AlexanderSobolev1990/sail_catamaran_taymen/doc/SpecificationSail.odt

Поз. обозна- чение | Наименование | Кол. | Примечание
1 | Деталь грота верхняя (1) | 1
2 | Деталь грота (2) | 1
3 | Деталь грота (3) | 1
4 | Деталь грота нижняя (4) | 1
5 | Мачтовый карман | 1
6 | Лик-карман | 1
7 | Гик-карман | 1
8 | Внешний боут фаловый | 1
9 | Внутренний боут фаловый | 1
10 | Внешний боут галсовый | 1
11 | Внутренний боут галсовый | 1
12 | Внешний боут шкотовый | 1
13 | Внутренний боут шкотовый | 1
14 | Верхний латкарман (меньший) | 1
15 | Нижний латкарман (больший) | 2

Грот Спецификация Лит. Лист 0 1 Листов 1 Разраб. Пров. Н. контр. Утв. Соболев Красавин Лунёв Изм. Лист № докум. Подп. Дата Инв. № подл. Подп. и дата Взам. инв. № Инв. № дубл. Подп. и дата Копировал Формат А4

Грот Спецификация Лит. Лист 0 Листов 1 Разраб. Пров. Н. контр. Утв. Соболев Красавин Лунёв Изм. Лист № докум. Подп. Дата Инв. № подл. Подп. и дата Взам. инв. № Инв. № дубл. Подп. и дата Справ. № Перв. примен. Копировал Формат А4

Грот Спецификация Лит. Лист 0 Листов 1 Разраб. Пров. Н. контр. Утв. Соболев Красавин Лунёв Изм. Лист № докум. Подп. Дата Инв. № подл. Подп. и дата Взам. инв. № Инв. № дубл. Подп. и дата Копировал Формат А4

Лист 0 Изм. Лист № докум. Подп. Дата Инв. № подл. Подп. и дата Взам. инв. № Инв. № дубл. Подп. и дата Копировал Формат А4
