AlexanderSobolev1990/sail_catamaran_taymen/doc/Specification.odt

Поз. обозна- чение | Наименование | Кол. | Примечание
1 | Байдарка «Таймень-3» | 2
3 | Ёмкость непотопляемости | 40 | 5л ПЭТ бутыль
4 | Кильсон в сборе | 2
5 | Фальшборт | 4
6 | Шпангоут | 10
7 | Штевень | 4
| Рама катамарана
11 | Бимс, труба дюраль d40x2000x1,6мм | 4
12 | Палуба, фанера 2000х460х6мм | 2
13 | Стрингер рамы, труба дюраль d40x2000x2мм | 3 | 2 колена с соединителями
14 | Шверт | 1
| Мачта и паруса
18 | Гик, труба дюраль d30x2000x2мм | 1
19 | Грот | 1
20 | Мачта, труба дюраль d40x2000x1,6мм | 2
21 | Пластина топа мачты, сталь s4мм | 1
22 | Соединитель мачты, труба сталь d36x200x2мм | 1
23 | Стаксель | 1
24 | Флюгарка тканевая красная | 1
25 | Шток флюгарки, нерж. сталь d4мм | 1
| Рулевое устройство
31 | Балер, труба дюраль d30x600x2мм | 1
32 | Перо руля, дюраль 2мм | 1
33 | Подшипник внутр. d6мм | 2
34 | Румпель, труба дюраль d30x400x2мм | 1
35 | Румпеля привод, труба дюраль d20x2000х1,5мм | 1
36 | Стакан балера внешний, труба дюраль d40x120x1,6мм | 1
37 | Стопор стакана балера, металлич. | 1
| Такелаж
41 | Блок двойной оттяжки гика | 1
42 | Блок одинарный оттяжки гика | 1
43 | Блок одинарный фала паруса с рымом, d40мм | 2
44 | Ванта мачты боковая, стальной трос d3мм | 2
45 | Ванта мачты носовая, стальной трос d3мм | 1
46 | Зажим стального троса 3мм на двух болтах | 19
47 | Карабин легкий без завинчивающегося стопора | 2
48 | Карабин с завинчивающимся стопором | 5
49 | Коуш | 18
50 | Сорлинь | 1
51 | Снасть подъёма шверта | 1
52 | Талреп крюк-кольцо 6мм | 9
53 | Трос носовой оттяжки стрингера, сталь d3мм | 1
54 | Трос кормовой оттяжки стрингера, сталь d3мм | 1
55 | Трос Х-образной растяжки рамы, сталь d3мм | 1
56 | Трос треугольной оттяжки боковой ванты | 2
57 | Фал грота, канат 6мм | 1
58 | Фал стакселя, канат 6мм | 1
59 | Шкот стакселя, канат 6мм | 1
60 | Шкот грота, канат 6мм | 1
| Хомуты
64 | Хомут, жесть s1мм | 1 | Для стакана балера
65 | Хомут для крепления вант мачты 40мм | 4 | Для двух вант
66 | Хомут поперечного соединения труб 40мм | 4 | Из двух элементов
67 | Хомут силовой для крепления к трубе 30мм | 2 | Для оттяжки гика
68 | Хомут силовой для крепления к трубе 40мм | 2 | Для оттяжки гика
69 | Хомут Т-образного соединения труб 30мм | 1 | Для балера
70 | Хомут Т-образного соединения труб 40мм | 2 | Для степса и балера
71 | Хомут Т-образного соединения труб 50мм | 1 | Для пятки гика
| Вставки усиления
75 | Вставка усиления балера и степса, труба дюраль d36x120x2мм | 2
76 | Вставка усиления бимса, труба дюраль d36x50x2мм | 8
77 | Вставка усиления конца стрингера, труба дюраль d36x150x2мм | 2 | В нос и корму
78 | Вставка усиления пятки гика, труба дюраль d58x120x2,5мм | 1
79 | Вставка усиления хомута пятки гика, дерево | 2
80 | Вставка усиления шпангоута, дерево | 8 | Между фанерой усиления
81 | Вставка усиления шпангоута, фанера 6мм | 16
82 | Вставка усиления топа мачты, труба дюраль d36x150x2мм | 1 | С прямоуг. отв. под (21)
| Метизы
95 | Болт М4 | 2 | Или винт М4
96 | Болт М6x60 | 3
97 | Винт М6x40 кадмиевый | 26
98 | Гайка М4 | 2
99 | Гайка М6 | 45
100 | Заклепка вытяжная d4мм | 4
101 | Рым-болт М6х60 | 17
102 | Рым-гайка М6 | 2
103 | Шайба М6 | 74

Парусный катамаран Спецификация Лит. Лист 1 Листов 4 Разраб. Пров. Н. контр. Утв. Соболев Красавин Лунёв Изм. Лист № докум. Подп. Дата Инв. № подл. Подп. и дата Взам. инв. № Инв. № дубл. Подп. и дата Копировал Формат А4

Парусный катамаран Спецификация Лит. Лист 0 Листов 4 Разраб. Пров. Н. контр. Утв. Соболев Красавин Лунёв Изм. Лист № докум. Подп. Дата Инв. № подл. Подп. и дата Взам. инв. № Инв. № дубл. Подп. и дата Справ. № Перв. примен. Копировал Формат А4

Парусный катамаран Спецификация Лит. Лист 0 Листов 4 Разраб. Пров. Н. контр. Утв. Соболев Красавин Лунёв Изм. Лист № докум. Подп. Дата Инв. № подл. Подп. и дата Взам. инв. № Инв. № дубл. Подп. и дата Копировал Формат А4

Лист 4 Изм. Лист № докум. Подп. Дата Инв. № подл. Подп. и дата Взам. инв. № Инв. № дубл. Подп. и дата Копировал Формат А4
