AlexanderSobolev1990/sail_catamaran_taymen/etc/A2toA4.png

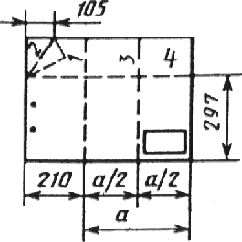
etc/A2toA4.png
