AlexanderSobolev1990/sail_catamaran_taymen/etc/Theoretical drawing of kayak Taymen-3.jpg

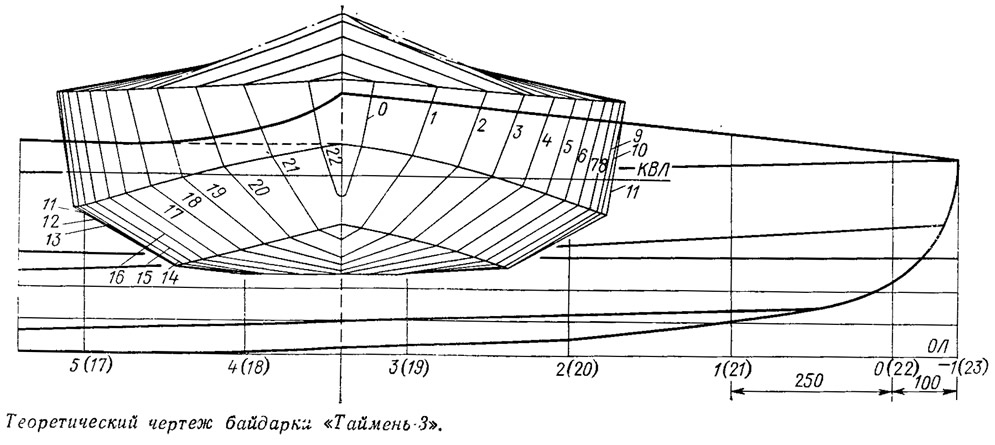
etc/Theoretical drawing of kayak Taymen-3.jpg
