AlexanderSobolev1990/sail_catamaran_taymen/doc/BOM.odt

№ п/п | Наименование (название,тип,номинал, тип корпуса и т.д.) | Обозначение документа на поставку (ГОСТ,ТУ, прайс-лист,каталог и т.п.) | Поставщик, адрес,телефон | Кол. | Ед. изм. | Примечание (цена поз., руб)
| Трубы Д16Т
1 | Труба d40x3000x2мм, | - | mpstar.ru | 2 | шт. | 16215
| с резкой пополам
2 | Труба d36x3000x2мм | - | mpstar.ru | 1 | шт. | 8050
| (резка 2м+1м)
3 | Труба d30x3000x3мм | - | mpstar.ru | 1 | шт. | 8855
| (резка 2м+1м)
4 | Труба d20x3000х2мм | - | mpstar.ru | 1 | шт. | 4620
| (рез 2,5м+0,5м)
| | | | | НДС: | 7548
| | | mpstar.ru | | | Итого:
| | | | | | 45288
| Хомуты
5 | Хомут для крепления | - | bgparus.ru | 4 | шт. | 2760
| вант мачты 40мм
6 | Хомут поперечного | - | bgparus.ru | 4 | шт. | 3120
| соединения труб 40x40мм
| (из двух элементов на гайках)
7 | Хомут силовой для | - | bgparus.ru | 2 | шт.
| крепления к трубе 30мм
8 | Хомут силовой для | - | bgparus.ru | 2 | шт. | 860
| крепления к трубе 40мм
9 | Хомут Т-образного | - | bgparus.ru | 1 | шт. | 325
| соединения труб 30х30мм
10 | Хомут Т-образного | - | bgparus.ru | 2 | шт. | 650
| соединения труб 40х40мм
11 | Хомут Т-образного | - | bgparus.ru | 1 | шт. | 325
| соединения труб 50х50мм
12 | Утка | - | bgparus.ru | 2 | шт. | 460
| Крепеж
13 | Защелка для соединения | - | bgparus.ru | 10 | шт. | 360
| труб (с 2-мя кнопками)
| | | bgparus.ru | | | Итого:
| | | | | | 8860
| Такелаж
14 | Гайка М6 самоконтр. | - | ozon.ru | 100 | шт. | 319
15 | Блок двойной | - | ozon.ru | 1 | шт. | 459
16 | Блок одинарный | - | ozon.ru | 1 | шт. | 526
17 | Блок с рымом | - | ozon.ru | 3 | шт. | 1449
18 | Болт М6x60 | - | ozon.ru | 30 | шт. | 266
19 | Зажим для троса 3мм | - | ozon.ru | 50 | шт. | 687
20 | Коуш | - | ozon.ru | 100 | шт. | 768
21 | Канат крученый 6мм | - | ozon.ru | 45 | м | 995
22 | Набор надфилей | - | ozon.ru | 1 | шт. | 454
23 | Подшипник внутр. d6мм | - | ozon.ru | 4 | шт. | 300
24 | Прут стальной на шток флюгарки | - | ozon.ru | 1 | шт. | 275
25 | Рым-гайка М6 | - | ozon.ru | 10 | шт. | 851
26 | Рым-болт М6х10 | - | ozon.ru | 4 | шт. | 418
27 | Рым-болт М6х60 | - | ozon.ru | 20 | шт. | 3992
28 | Талреп М6 | - | ozon.ru | 10 | шт. | 2597
29 | Трос стальной 50м x 3мм | - | ozon.ru | 1 | шт. | 1700
30 | Фиксатор резьбы | - | ozon.ru | 1 | шт. | 677
31 | Шайба М6 | - | ozon.ru | 100 | шт. | 182
| | | ozon.ru | | | Итого:
| | | | | | 16915
| Паруса
32 | Ткань Оксфорд (Oxford) | - | ozon.ru | 1 | шт | 1025
| 600D/1000PU 220г/м²
| 150см x 5м

Парусный катамаран Ведомость покупных изделий Лит. Лист 1 Листов 4 Разраб. Пров. Н. контр. Утв. Соболев Красавин Лунёв Изм. Лист № докум. Подп. Дата Инв. № подл. Подп. и дата Взам. инв. № Инв. № дубл. Подп. и дата Копировал Формат А4

Парусный катамаран Ведомость покупных изделий Лит. Лист 0 Листов 4 Разраб. Пров. Н. контр. Утв. Соболев Красавин Лунёв Изм. Лист № докум. Подп. Дата Инв. № подл. Подп. и дата Взам. инв. № Инв. № дубл. Подп. и дата Справ. № Перв. примен. Копировал Формат А4

Парусный катамаран Ведомость покупных изделий Лит. Лист 0 Листов 4 Разраб. Пров. Н. контр. Утв. Соболев Красавин Лунёв Изм. Лист № докум. Подп. Дата Инв. № подл. Подп. и дата Взам. инв. № Инв. № дубл. Подп. и дата Копировал Формат А4

Лист 4 Изм. Лист № докум. Подп. Дата Инв. № подл. Подп. и дата Взам. инв. № Инв. № дубл. Подп. и дата Копировал Формат А4
