AlexanderSobolev1990/sail_catamaran_taymen/jpg/parts.JPG

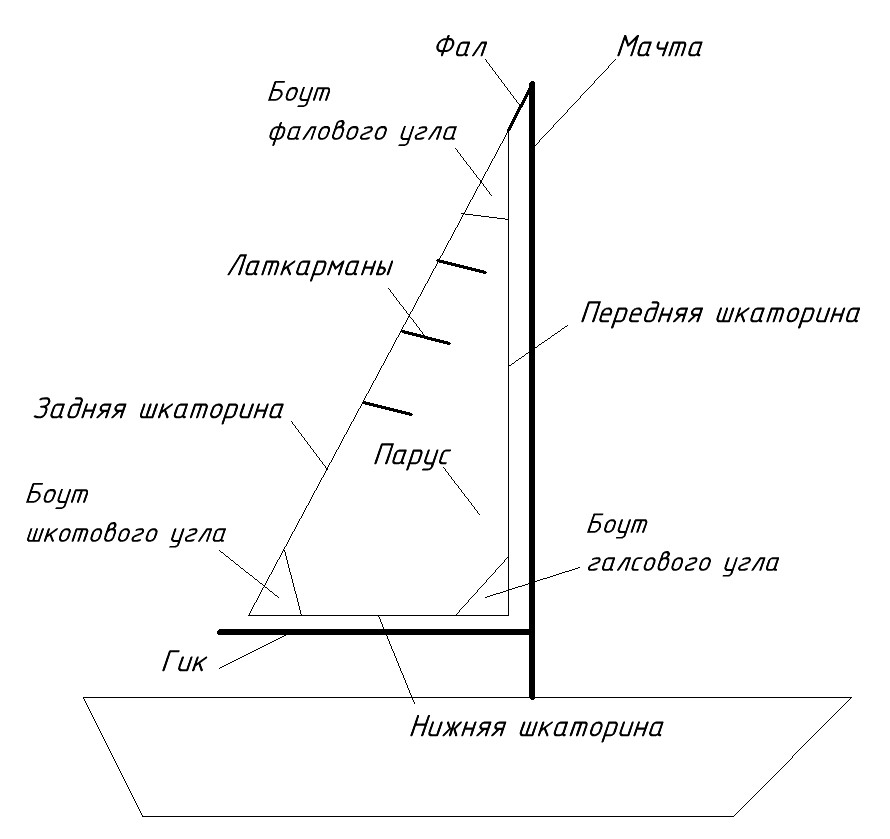
jpg/parts.JPG
