AlexanderSobolev1990/sail_catamaran_taymen/pdf/Assembly drawing.pdf

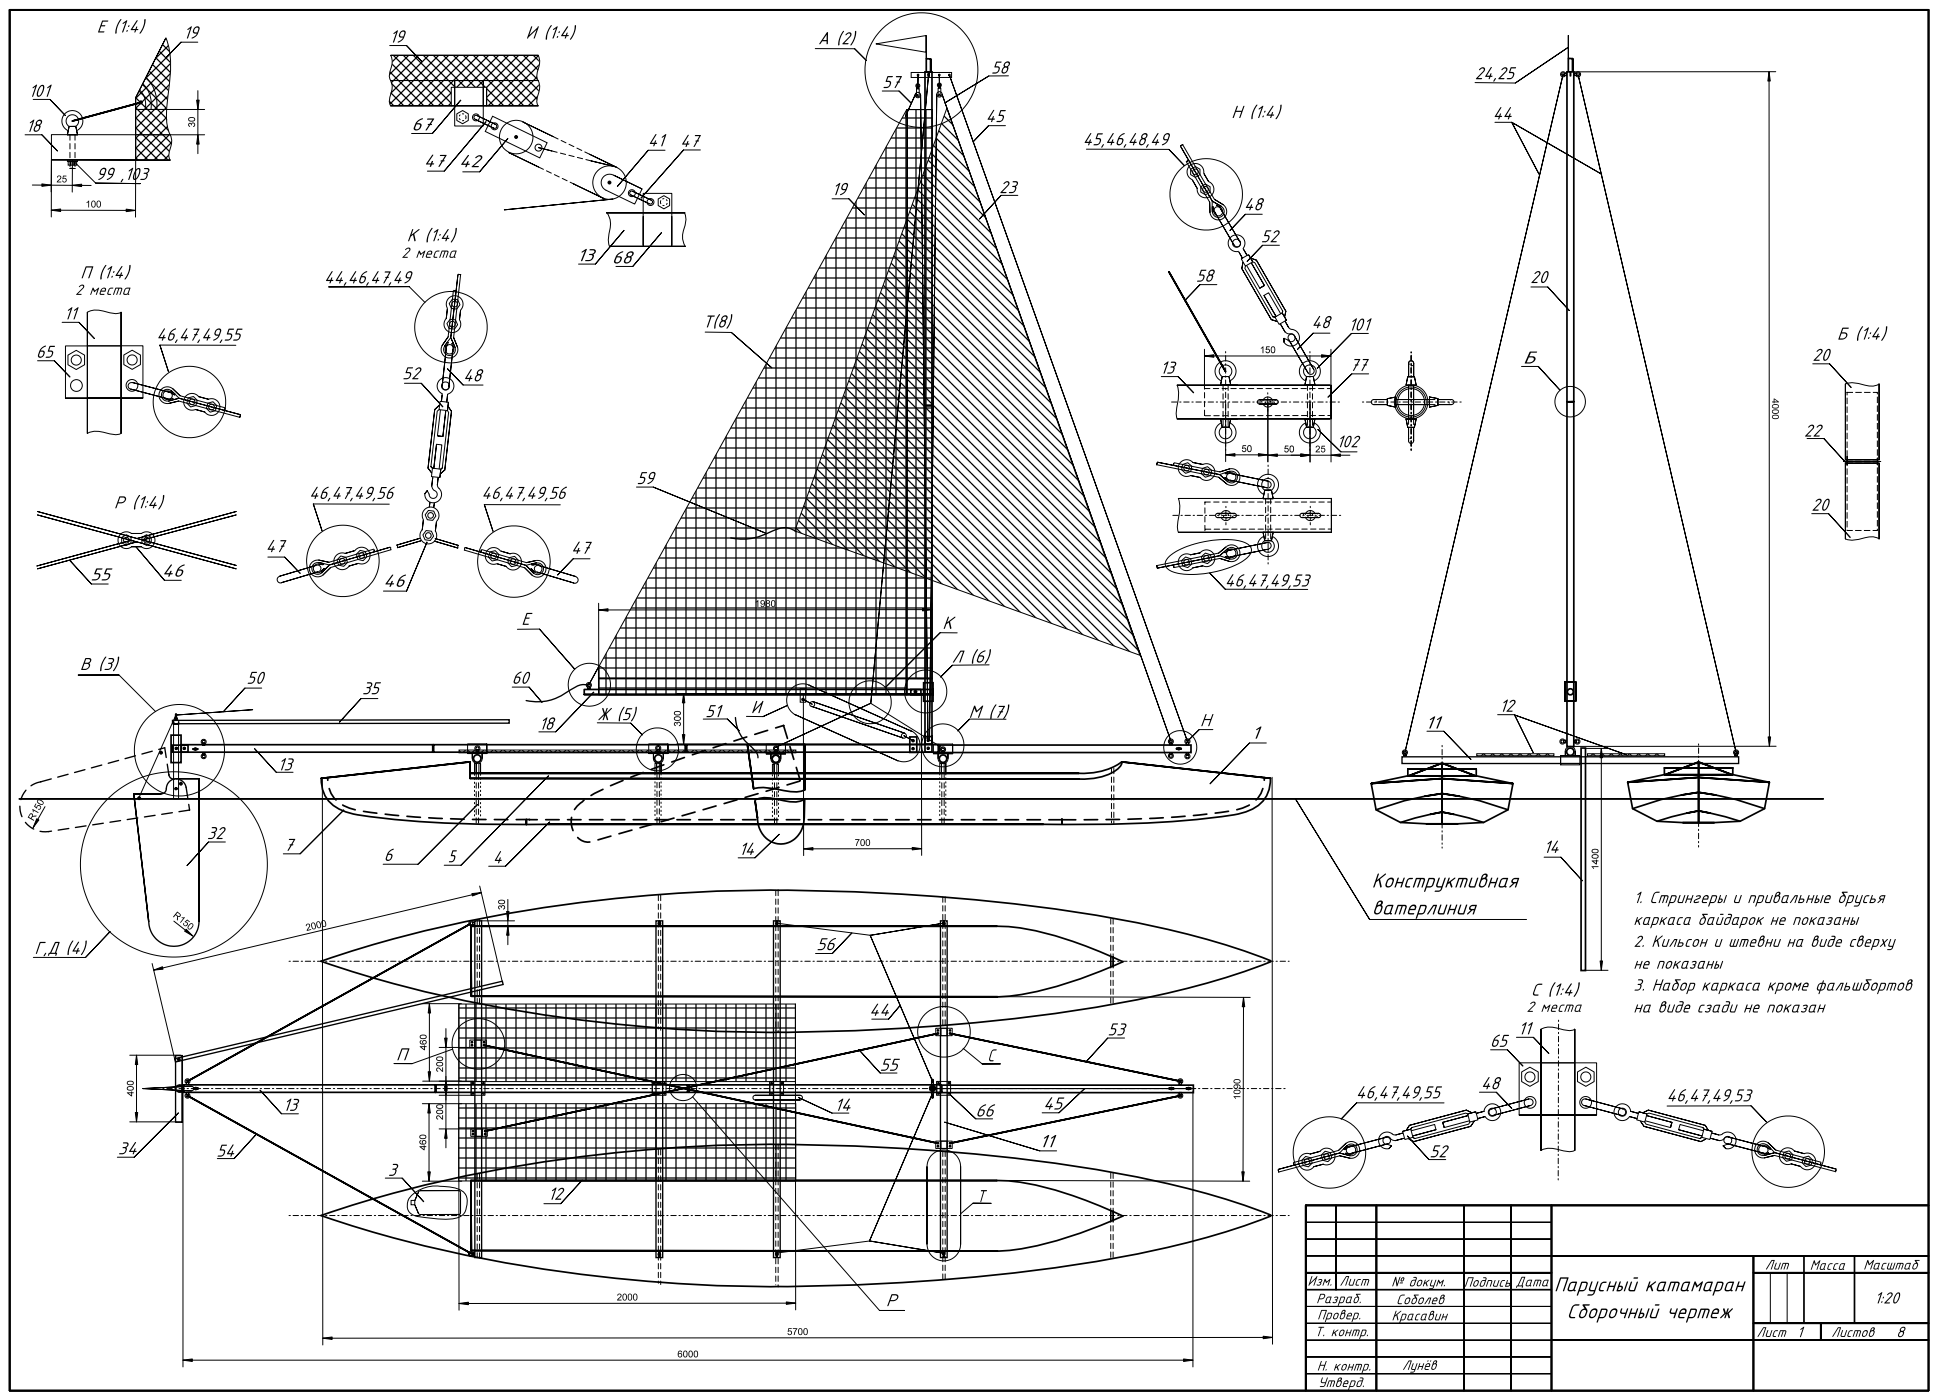
[picture p16: page 1]
