AlexanderSobolev1990/sail_catamaran_taymen/pdf/Cut.pdf

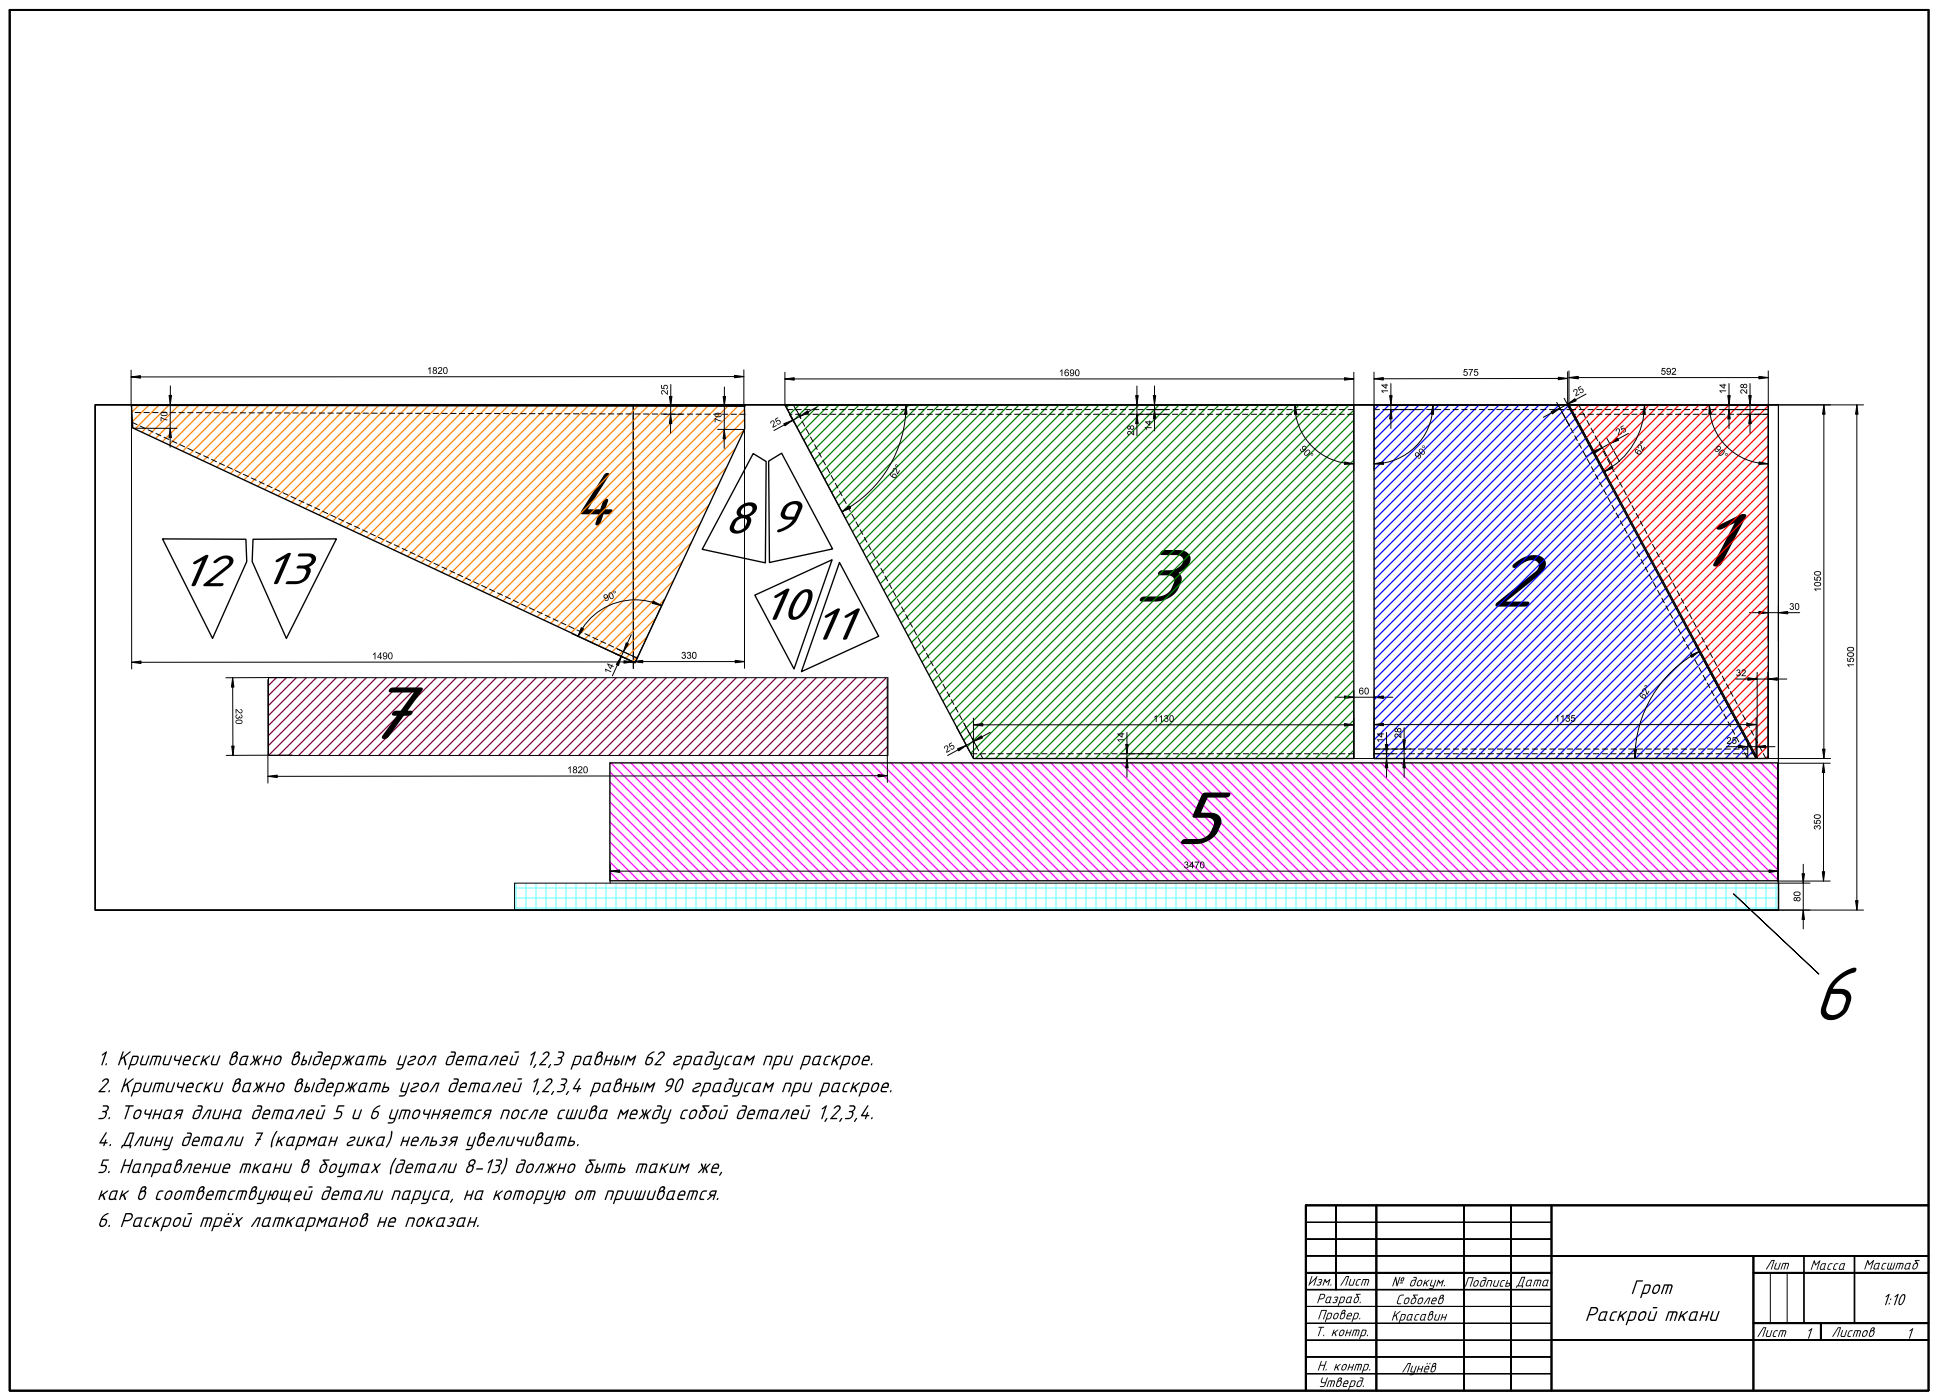
[picture p17: page 1]
