AlexanderSobolev1990/sail_catamaran_taymen/pdf/Grot views.pdf

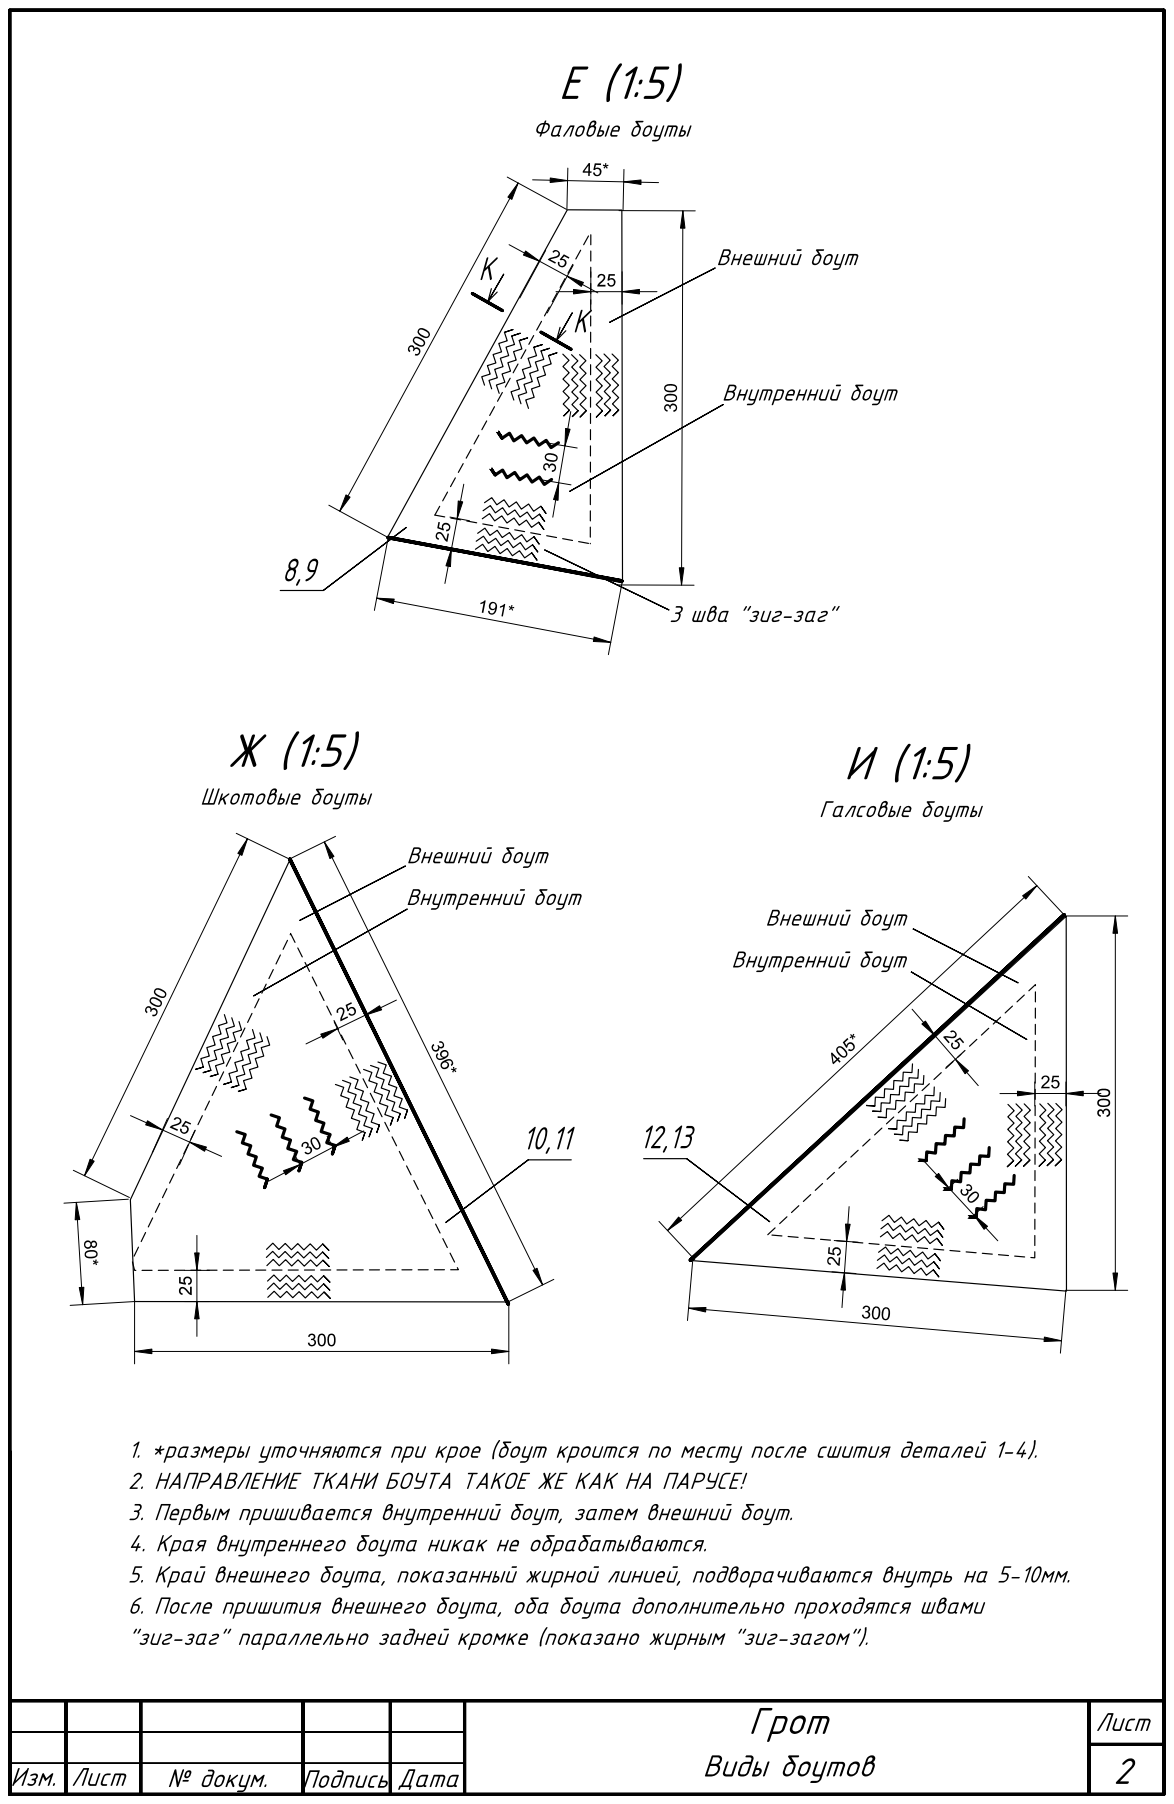
[picture p18: page 1]

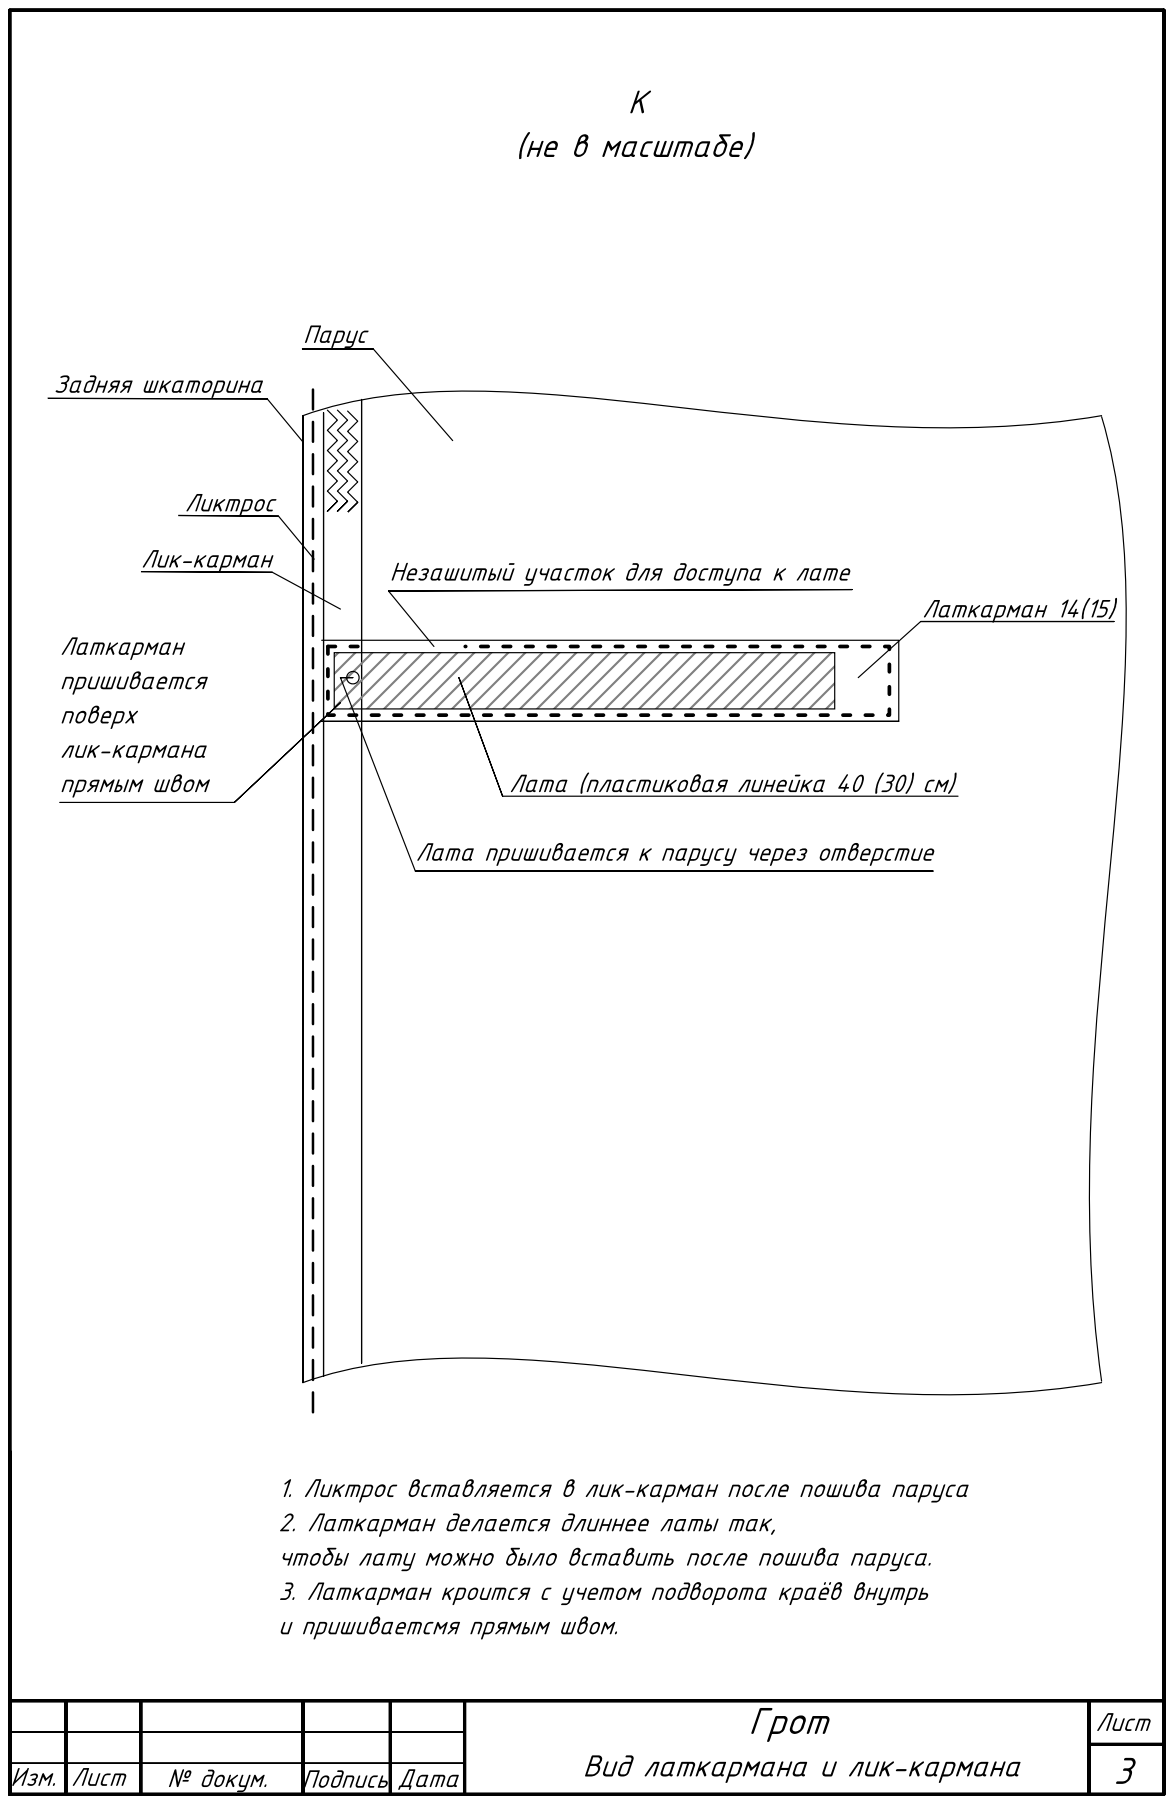
[picture p19: page 2]
