AlexanderSobolev1990/sail_catamaran_taymen/pdf/Grot.pdf

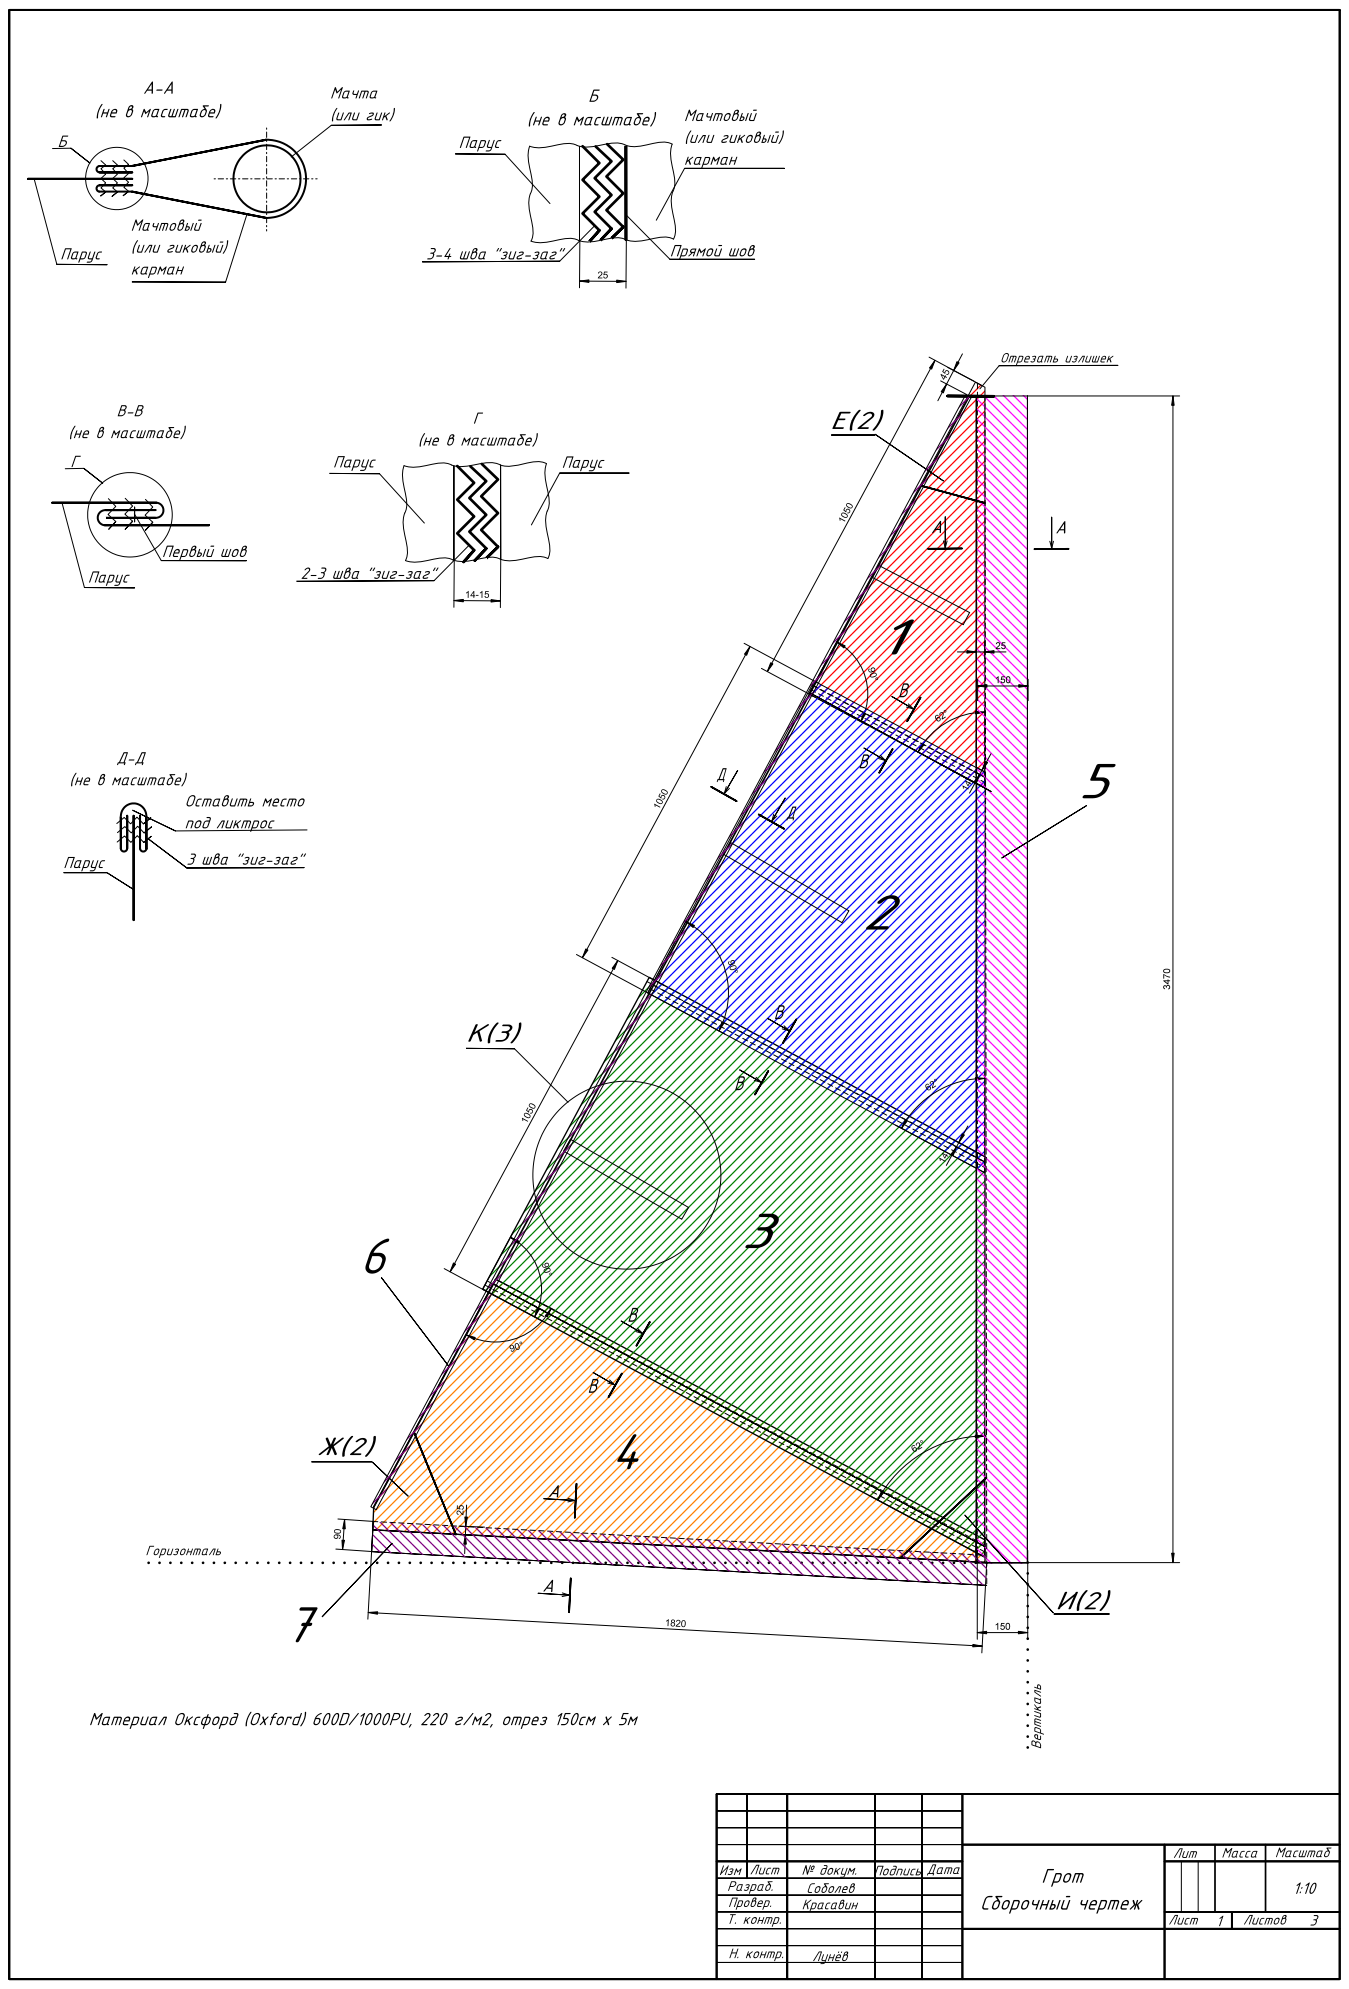
[picture p27: page 1]
