AlexanderSobolev1990/sail_catamaran_taymen/(list of files, drawings)

Other design files:
src/Assembly drawing.spl7
src/Drawing views.spl7
src/Elements2.spl7
src/Elements.spl7
src/Grot.spl7
