AlexanderSobolev1990/sail_catamaran_taymen/(commit log)

2024-06-24 24-06-24 evening
    [Assembly drawing.spl7, Drawing views.spl7]
2024-06-26 fixed drawings, introduced bom
    [Assembly drawing.spl7, Drawing views.spl7]
2024-06-26 26.26.24 added sail
    [Assembly drawing.spl7, Drawing views.spl7, Grot.spl7]
2024-06-28 replaced files, new revision
    [Assembly drawing.spl7, Drawing views.spl7, Elements.spl7]
2024-06-28 minor fixes
    [Assembly drawing.spl7, Grot.spl7]
2024-06-28 updated grot
    [Drawing views.spl7, Grot.spl7]
2024-07-02 02-07-24 2
    [Assembly drawing.spl7, Drawing views.spl7, Grot.spl7]
2024-08-12 after first sailing
    [Assembly drawing.spl7, Drawing views.spl7, Grot.spl7]
