AlexanderSobolev1990/sail_catamaran_taymen/jpg/2.jpg

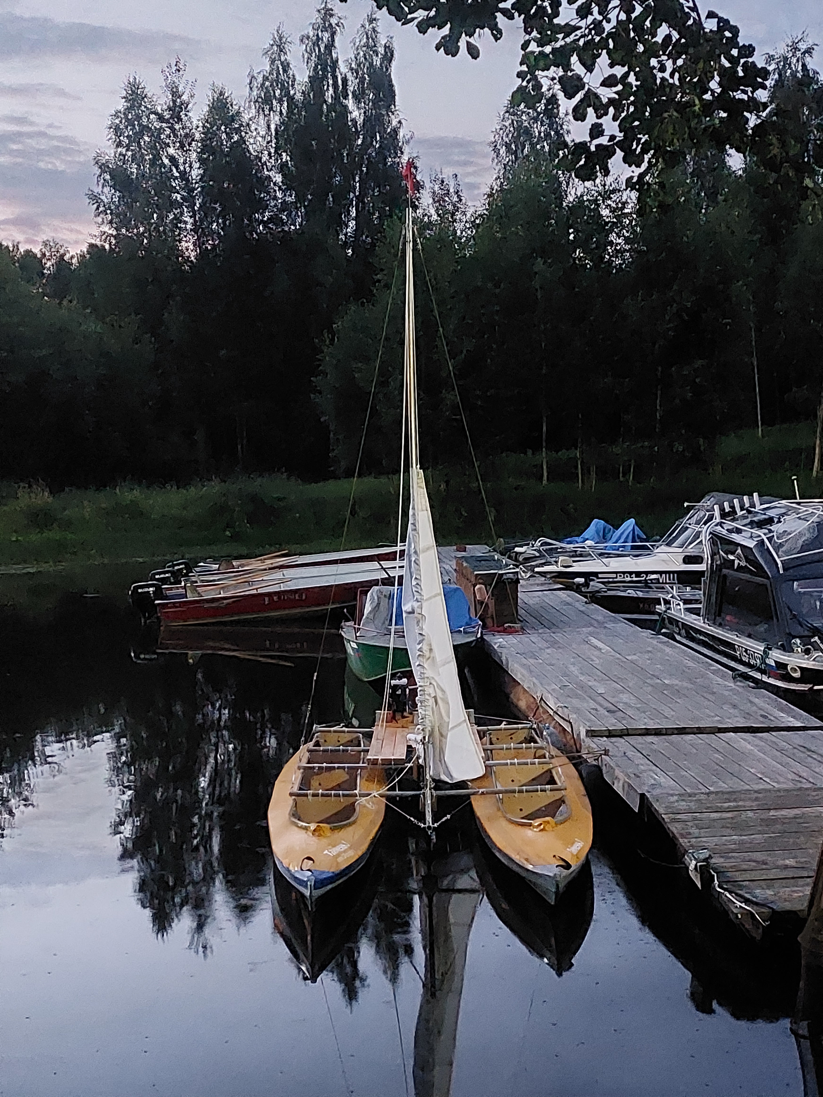
[picture p1: jpg/2.jpg]
jpg/2.jpg
